guiguijke/OpenPowder/doc/OpenPowder V2.2_bb.png

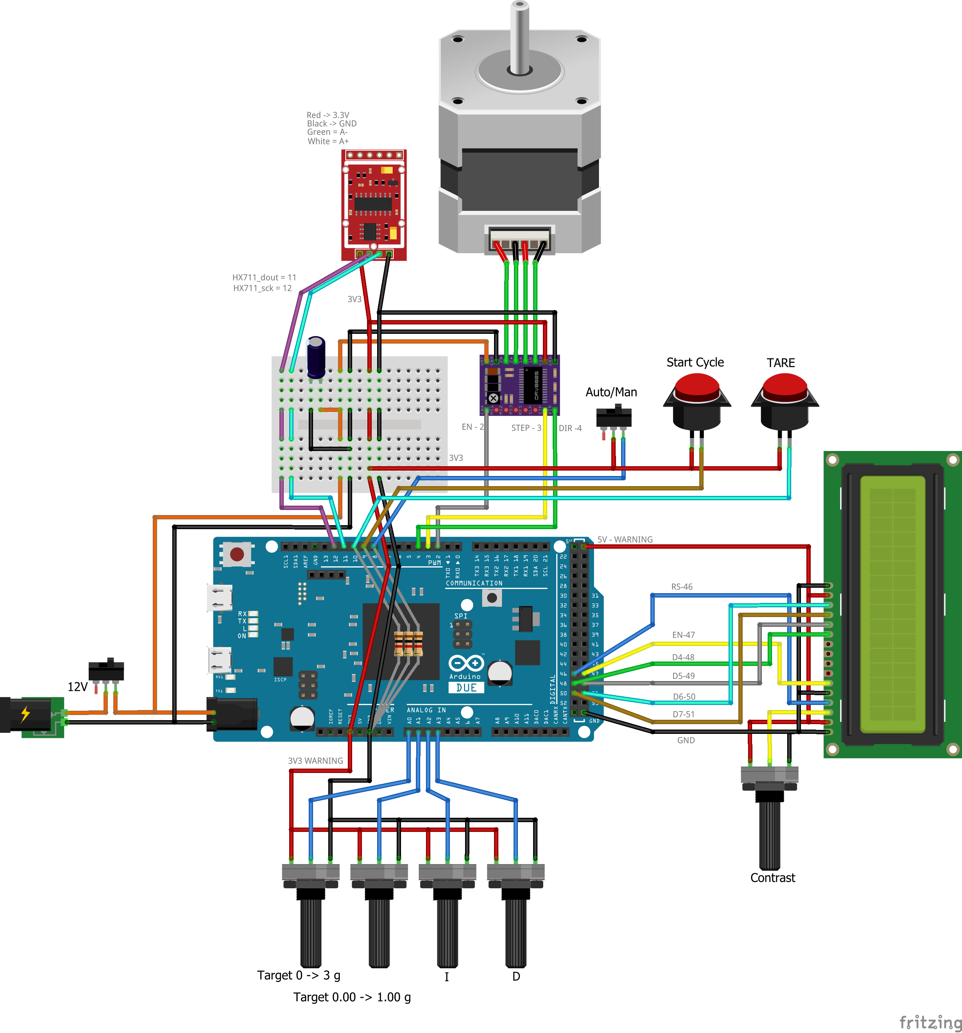
doc/OpenPowder V2.2_bb.png
