guiguijke/OpenPowder/doc/OPEN POWDER BILL OF MATERIAL.xlsx

OPEN POWDER BILL OF MATERIAL
 | M3 rondelles | 4 | 9.32 € | RONM03A2 | https://www.bricovis.fr
 | M3 12mm | 4 |  | TCHC03/012A12NOEF
 | M3 25mm | 2 |  | TCHC03/025A12NOEF
 | M2.5 12mm | 2 |  | TCHC02.5/012A12NOE
 | M2.5 10mm | 2 |  | TCHC02.5/010A12NOE
 | Arduino Mega | 1 | 8.18 € | https://fr.banggood.com/Geekcreit-MEGA-2560-R3-ATmega2560-MEGA2560-Development-Board-With-USB-Cable-For-Arduino-p-73020.html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
 | Arduino UNO | 1 | 1.45 € | https://fr.banggood.com/ATmega328P-Nano-V3-Controller-Board-Compatible-Arduino-p-940937.html?cur_warehouse=CN
 | Ecran LCD 20x4 | 1 | 8.15 € | https://fr.banggood.com/IIC-I2C-2004-204-20-x-4-Character-LCD-Display-Module-Blue-p-908616.html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
 | Clavier 4x4 | 1 (0 for pot version -> advised) | 2.07 € | https://www.banggood.com/16Keys-4-x-4-SCM-Matrix-External-Expansion-Keyboard-Contral-Board-p-965541.html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
 | BEC 5v | 1 | 2.47 € | https://fr.banggood.com/7V-28V-to-5V-3A-Voltage-Regulator-Mini-Power-Module-BEC-UBEC-For-Gimbal-FC-FPV-RC-Drone-p-1318624.html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
 | 12V Power Supply | 1 | 4.04 € | https://fr.banggood.com/DC-12V-2A-Power-Supply-Adapter-5_52_1mm-DC-for-Security-Camera-LED-Strip-Bar-Light-EU-US-AU-UK-Plug-p-1276868.html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
 | Condensateur 25V 1000µF | 1 | 1.84 € | https://fr.banggood.com/20pcs-1000uF-25V-Radial-Electrolytic-Capacitor-10-x-17mm-105C-p-1022623.html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
 | Resistor 1kOhm | 2 | 2.51 € | https://www.banggood.com/300Pcs-1-14W-Metal-Film-Resistor-Resistance-30-Values-Assortment-Kit-p-1091920.html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
 | PCB Board kit | 1 | 11.29 € | https://www.amazon.fr/gp/product/B076TD3LMG/ref=ppx_yo_dt_b_asin_title_o05_s01?ie=UTF8&psc=1
 | Dupont cables MM | 1 | 1.92 € | https://www.banggood.com/40pcs-20cm-Male-To-Male-Color-Breadboard-Cable-Jumper-Cable-Dupont-Wire-p-70127.html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
 | Solderless PCB Breadboard | 1 | 2.82 € | https://www.banggood.com/Wholesale-Test-Develop-DIY-830-Point-Solderless-PCB-Bread-Board-For-MB-102-MB102-p-51331.html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
 | Potentiometer | 1 (4 for pot version) | 1.26€ | https://www.banggood.com/1-2-5-10-20-50-100-250-500-1000K-Ohm-Potentiometers-Single-Linear-p-919185.html?ID=47793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
 | HX711 | 1 | 1.81 € | https://fr.banggood.com/AD-Weighing-Sensor-Module-Dual-channel-24-bit-AD-Conversion-HX711-Shieding-p-1039638.html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
 | Load Cell 100g | 1 | 9.70 € | https://www.lextronic.fr/capteur-de-charge-czl639hd-100-g-39482.html
 | Poids Calibrage M2 +/- 0,003g | 1 | 15.34 € | https://www.amazon.fr/gp/product/B01MXZVNRN/ref=ppx_yo_dt_b_asin_title_o07_s00?ie=UTF8&psc=1
 | Stepper TMC2208 | 1 | 5.67 € | https://fr.banggood.com/TMC2208-Stepping-Motor-Mute-Built-in-Driver-Replace-TMC2100-For-3D-Printer-p-1243870.html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
 | NEMA 17 | 1 | 9.99 € | https://fr.banggood.com/Nema17-59Ncm-2A-1_84-lead-48mm-Stepper-Motor-For-3D-Printer-CNC-p-1252415.html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
 | Impression 3D Boite Arduino | 1 | 25€ | https://www.treatstock.fr
 |  |  |  | https://www.thingiverse.com/thing:360511
 | Impression 3D OpenPowder | 1 | 50€ | https://www.treatstock.fr
