guiguijke/OpenPowder/(threads)

Thread 2 (2022-05-05):

BOM not available

jasonhejna, 2022-05-05:
Hello,

It looks like the BOM is not working here, or through thingiverse. Would love an update. Thanks!

guiguijke, 2025-07-04:
Bom is there now
